nip2/pll-design/Lab1/figures/pics/resonator-pics/resonator.jpg

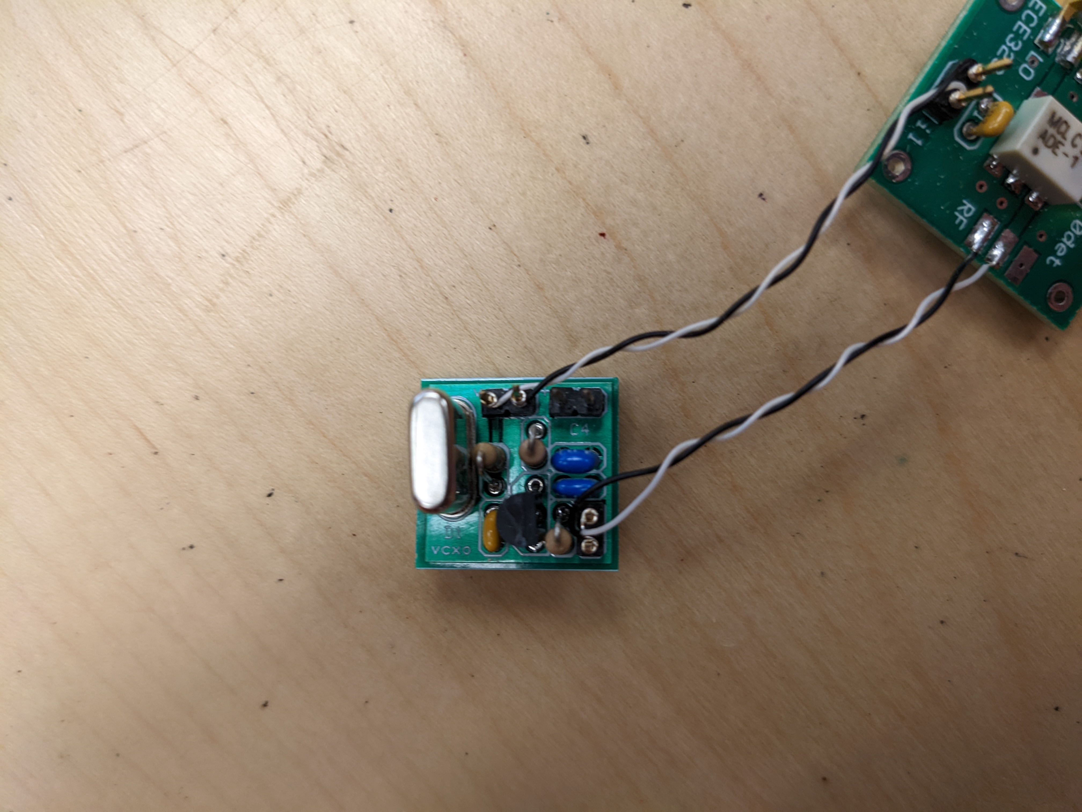
Lab1/figures/pics/resonator-pics/resonator.jpg
