nip2/pll-design/README.md

# pll-design
Design notes for building a phase locked loop from basic electrical components
