nip2/pll-design/Lab1/figures/L_stray.png

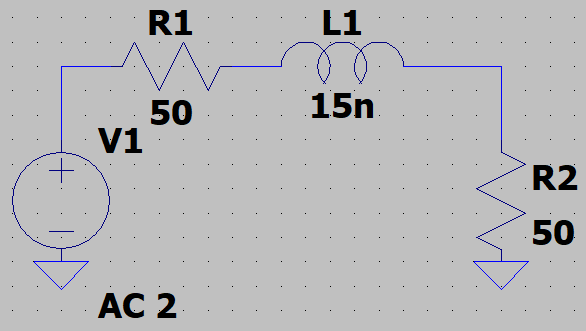
Lab1/figures/L_stray.png
