nip2/pll-design/Lab1/figures/L_stray_plot.png

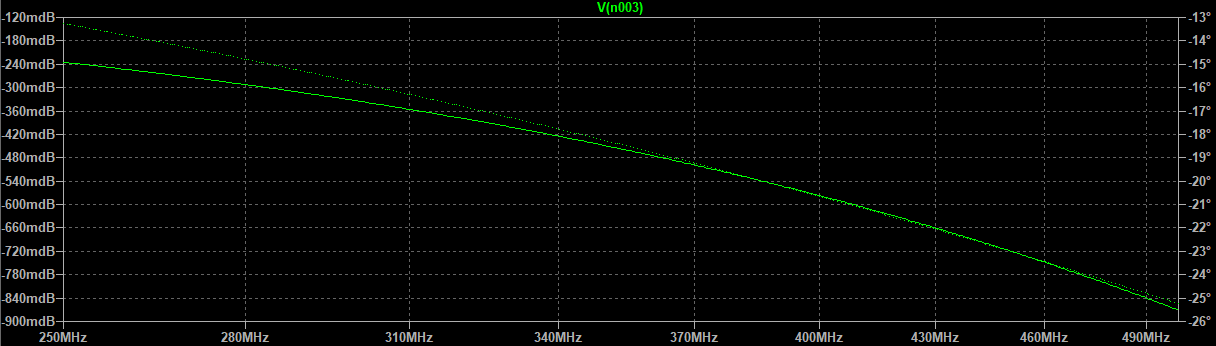
Lab1/figures/L_stray_plot.png
