nip2/pll-design/Lab1/figures/L_xfmr_plot.png

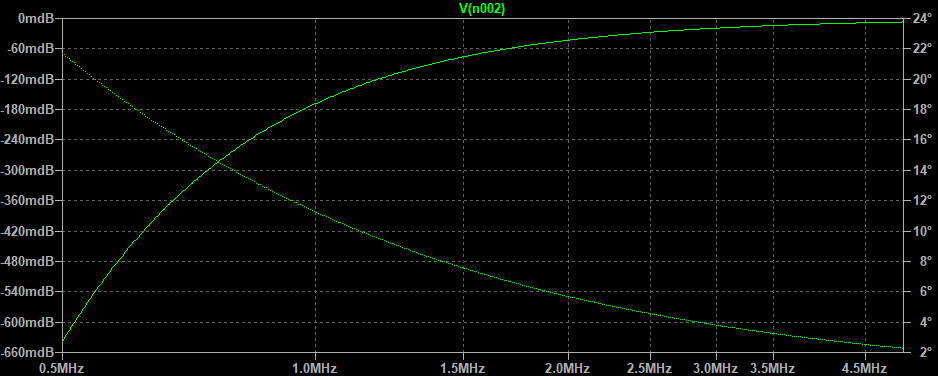
Lab1/figures/L_xfmr_plot.png
