nip2/pll-design/Lab1/figures/pics/ade1.jpg

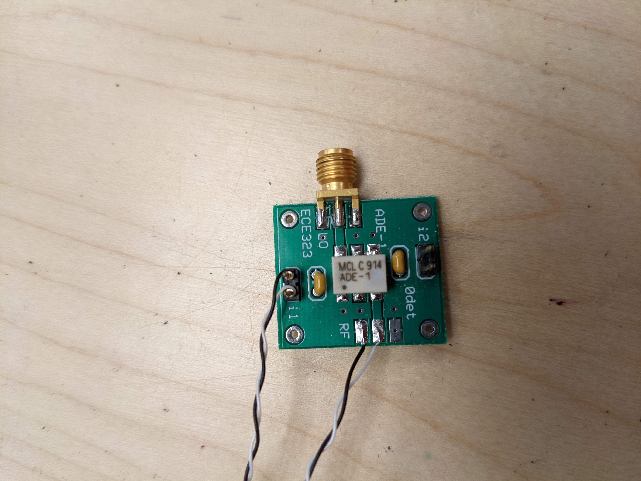
Lab1/figures/pics/ade1.jpg
