nip2/pll-design/Lab1/figures/pics/resonator-diag.jpg

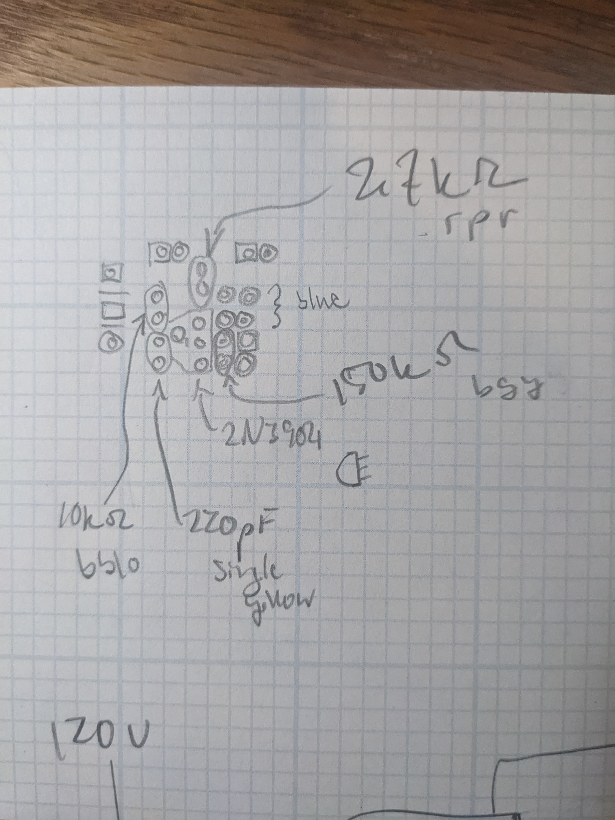
Lab1/figures/pics/resonator-diag.jpg
