nip2/pll-design/Lab1/figures/trifiler_ckt.png

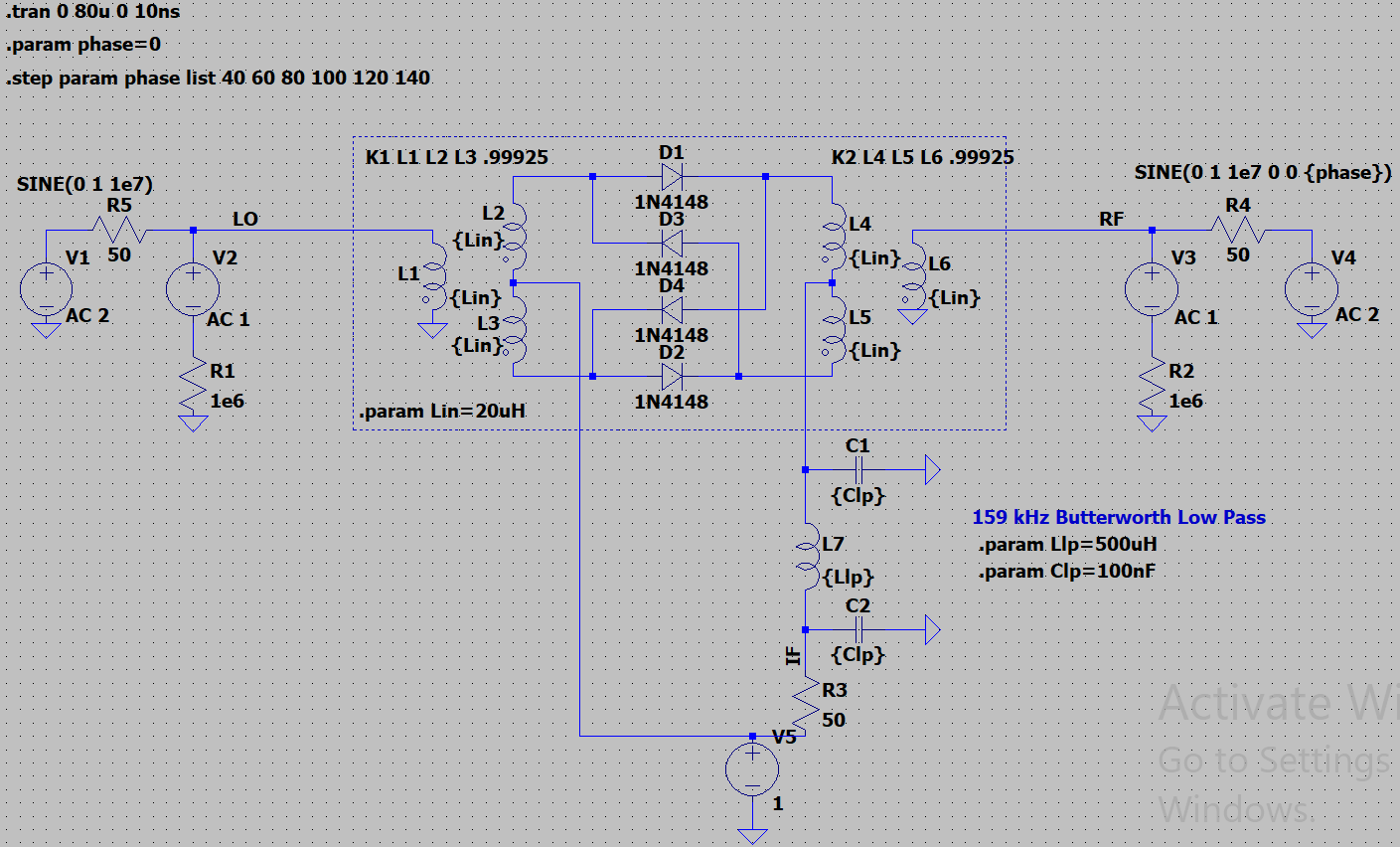
Lab1/figures/trifiler_ckt.png
