nip2/pll-design/Lab1/figures/trifiler_trans.png

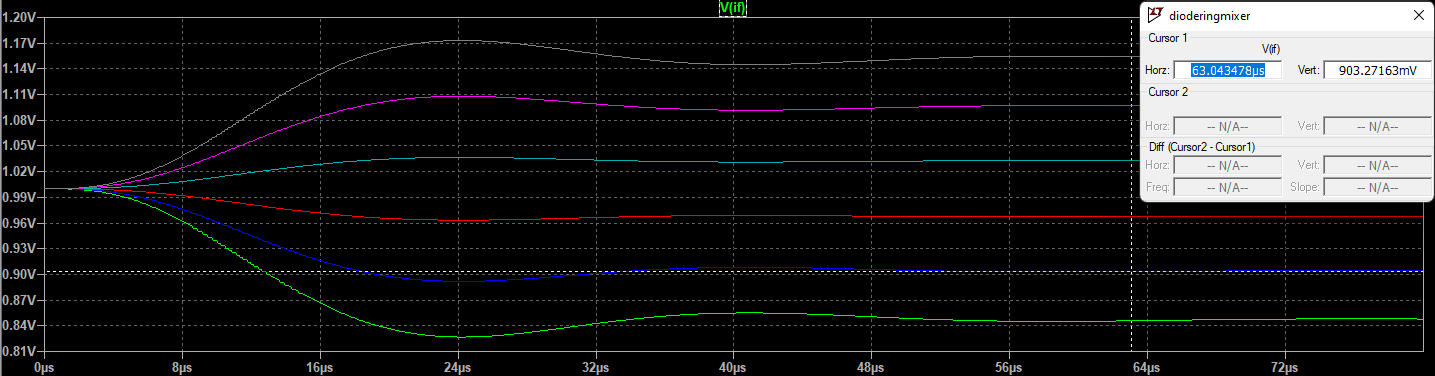
Lab1/figures/trifiler_trans.png
