nip2/pll-design/Lab1/plot.jpg

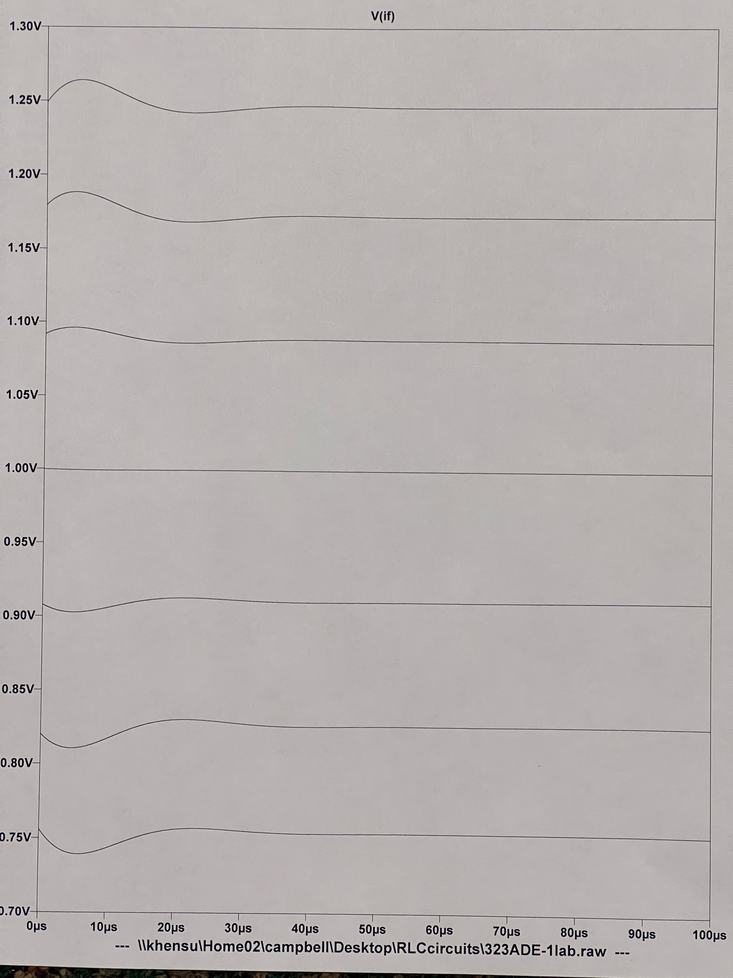
Lab1/plot.jpg
