nip2/pll-design/Lab1/SBL-1.png

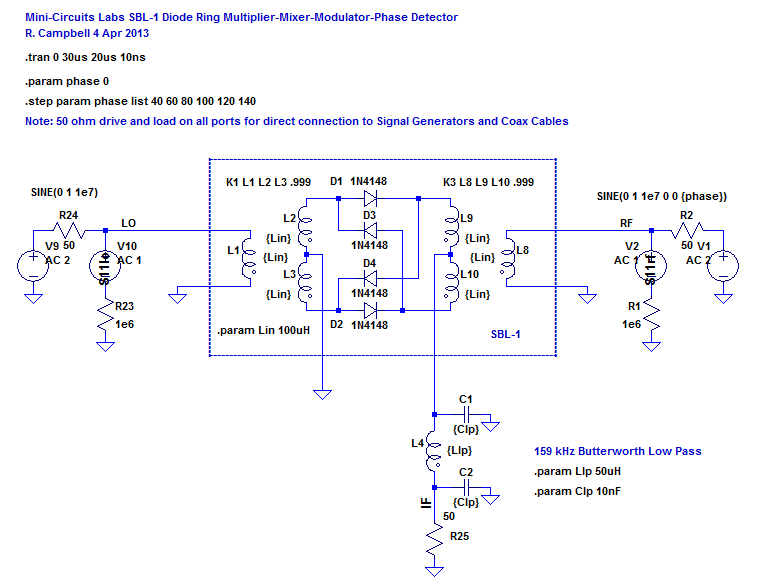
Lab1/SBL-1.png
