nip2/pll-design/Lab1/sim.jpg

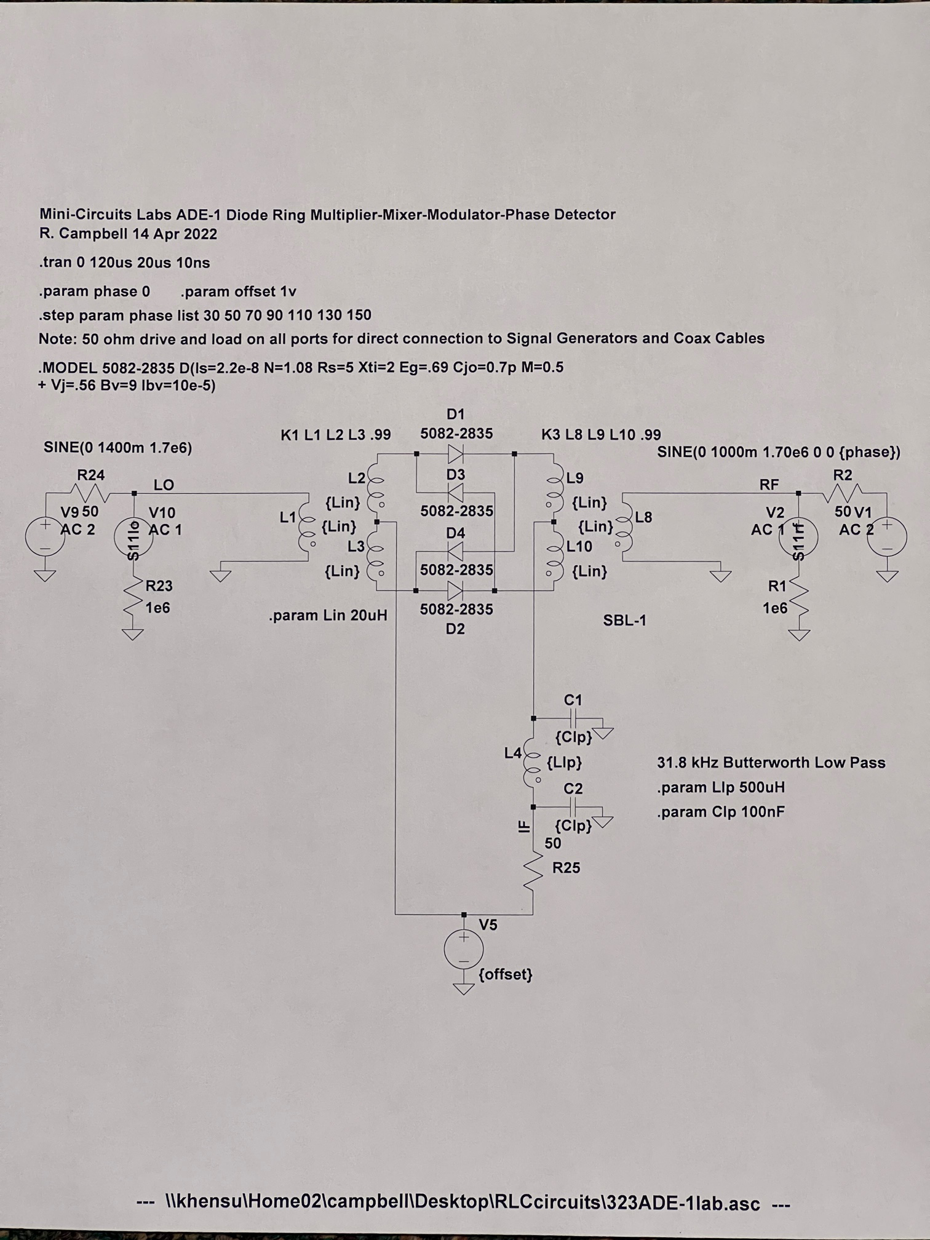
Lab1/sim.jpg
