nip2/pll-design/Lab2/figs/kphi_5v_24042800Hz.bmp

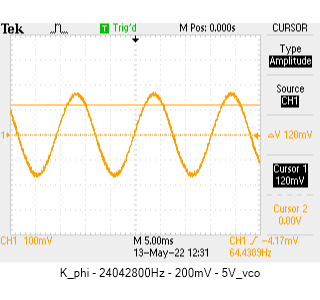
Lab2/figs/kphi_5v_24042800Hz.bmp
