nip2/pll-design/Lab2/figs/png/VCXO - 0.5vin.png

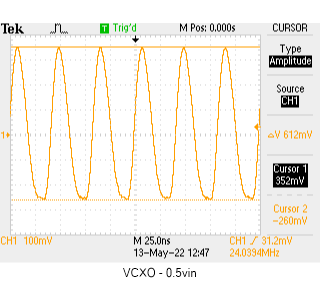
Lab2/figs/png/VCXO - 0.5vin.png
