nip2/pll-design/Lab2/figs/png/VCXO - 1vin.png

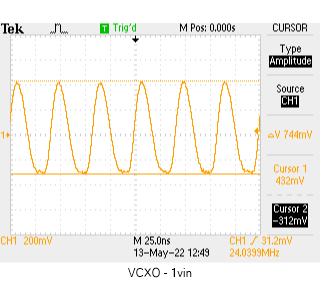
Lab2/figs/png/VCXO - 1vin.png
