nip2/pll-design/Lab2/figs/VCXO - 9vin.bmp

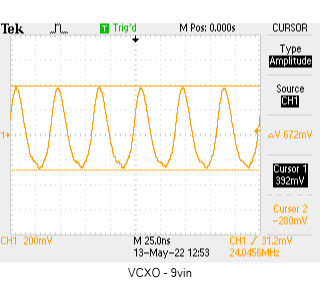
Lab2/figs/VCXO - 9vin.bmp
