nip2/pll-design/Lab2/vcxo-kphi.png

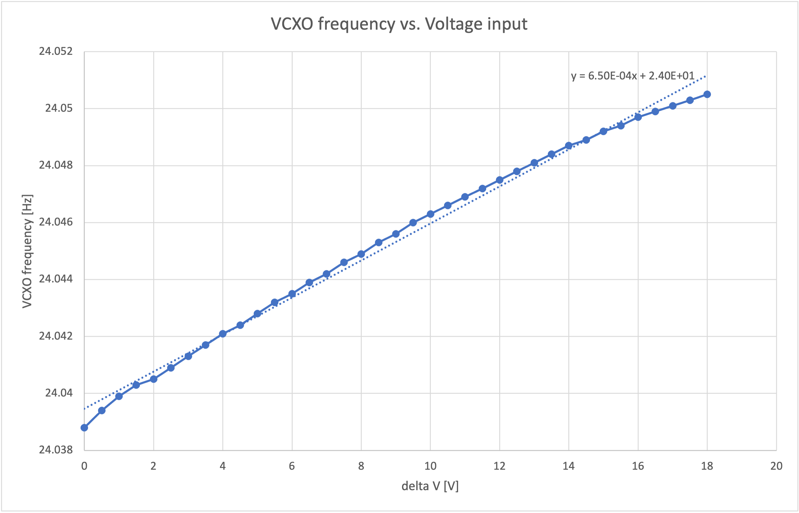
Lab2/vcxo-kphi.png
