nip2/pll-design/Lab3/figs/HF.png

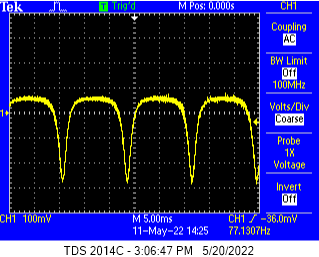
Lab3/figs/HF.png
