nip2/pll-design/Lab3/figs/HFedge.png

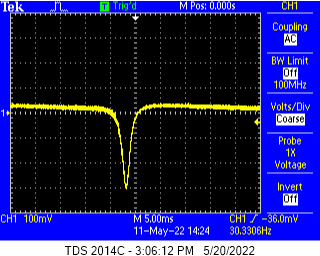
Lab3/figs/HFedge.png
