nip2/pll-design/Lab3/figs/LF.png

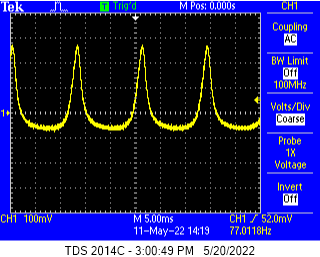
Lab3/figs/LF.png
