nip2/pll-design/Lab3/figs/LFedge.png

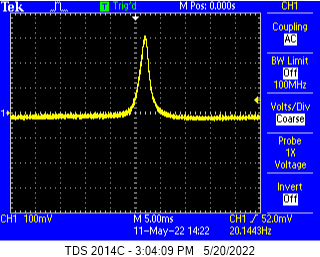
Lab3/figs/LFedge.png
