nip2/pll-design/Lab3/figs/PXL_20220531_184850895.jpg

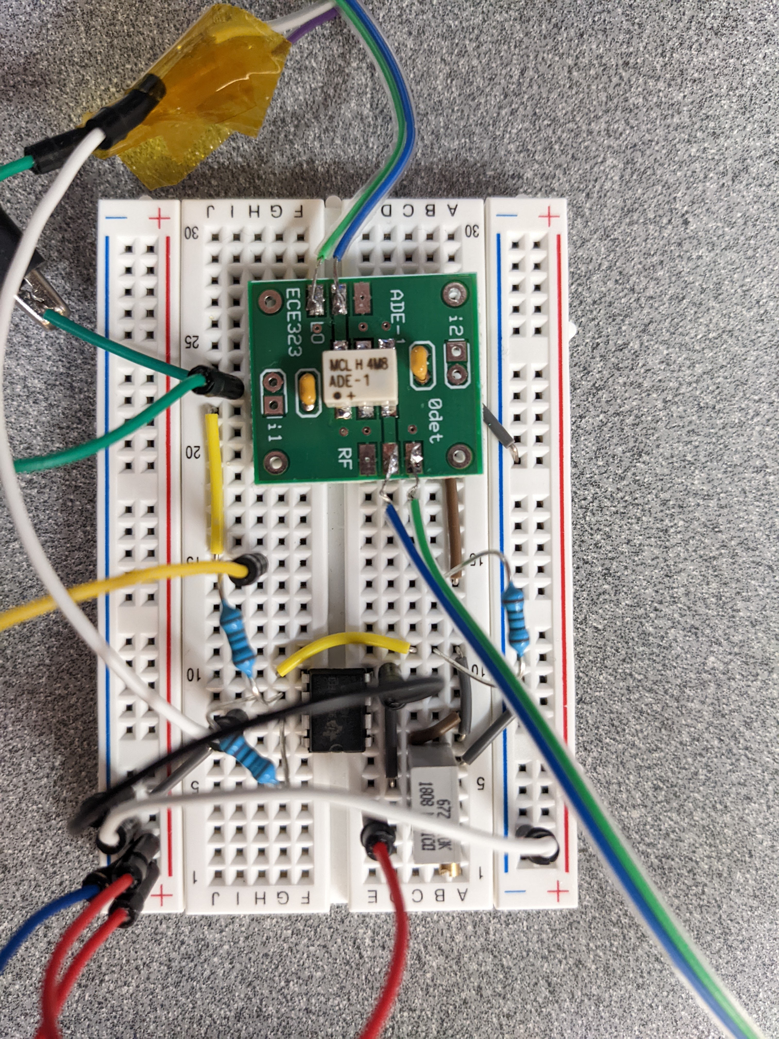
Lab3/figs/PXL_20220531_184850895.jpg
