nip2/pll-design/Lab3/figs/wgain/HF_lockedge.png

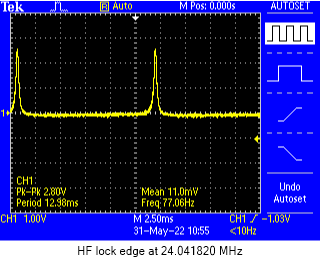
Lab3/figs/wgain/HF_lockedge.png
