nip2/pll-design/Lab3/figs/wgain/LF_lockedge.png

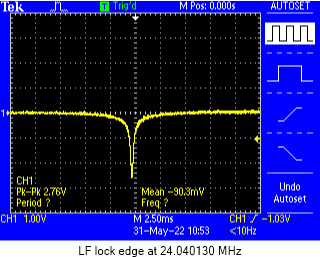
Lab3/figs/wgain/LF_lockedge.png
