nip2/pll-design/Lab3/schematic.png

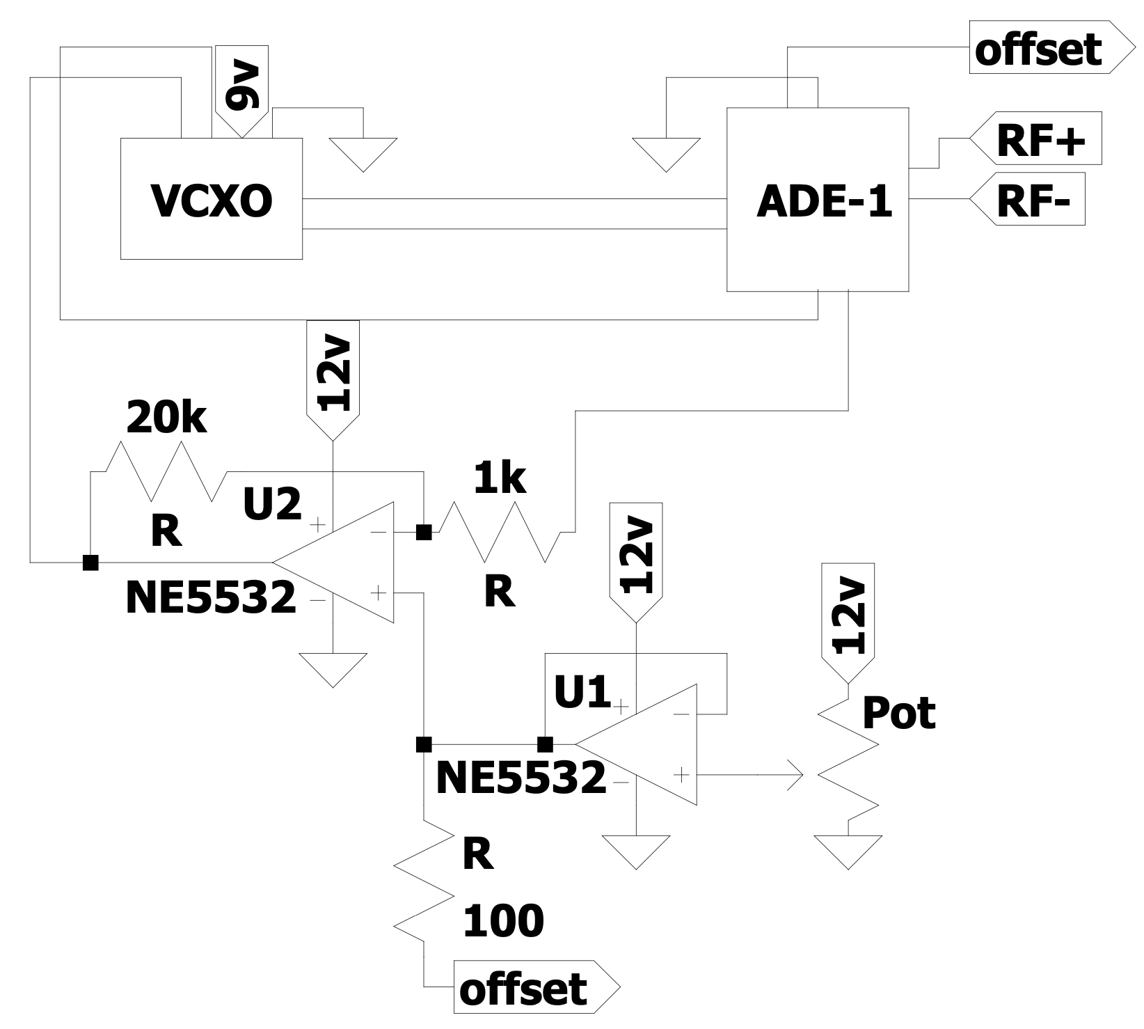
Lab3/schematic.png
