nip2/pll-design/Lab1/dioderingmixer.asc

C1: cap; {Clp}
C2: cap; {Clp}
D1: diode; 1N4148
D2: diode; 1N4148
D3: diode; 1N4148
D4: diode; 1N4148
L1: ind2; {Lin}
L2: ind2; {Lin}
L3: ind2; {Lin}
L4: ind2; {Lin}
L5: ind2; {Lin}
L6: ind2; {Lin}
L7: ind; {Llp}
R1: res; 1e6
R2: res; 1e6
R3: res; 50
R4: res; 50
R5: res; 50
V1: voltage; SINE(0 1 1e7); AC 2
V2: voltage; ""; AC 1
V3: voltage; ""; AC 1
V4: voltage; SINE(0 1 1e7 0 0 {phase}); AC 2
Named nets: 0, LO, IF, RF
K1 L1 L2 L3 .997
K2 L4 L5 L6 .997
.param Lin 100uH
159 kHz Butterworth Low Pass
.param Llp 50uH
.param Clp 10nF
.tran 0 30us 20us 10ns
.param phase 0
.step param phase list 40 60 80 100 120 140
