nip2/pll-design/Lab1/Lind.asc

L1: ind; 5µ
R1: res; 50
R2: res; 50
V1: voltage; SINE(0 2); AC 2
Named nets: 0
.ac dec 1k 10 500Meg
