nip2/pll-design/Lab3/PLL.asc

1k: res
20k: res
ADE-1: ADE1mock; ADE-1
Pot: pot; ""
R: res; 100
U1: opamp2; NE5532
U2: opamp2; NE5532
X1: VCXOmock
Named nets: 12v, 0, 9v, RF+, RF-, offset
ADE-1
VCXO
